gerryvel/NMEA2000_TPW/image.png

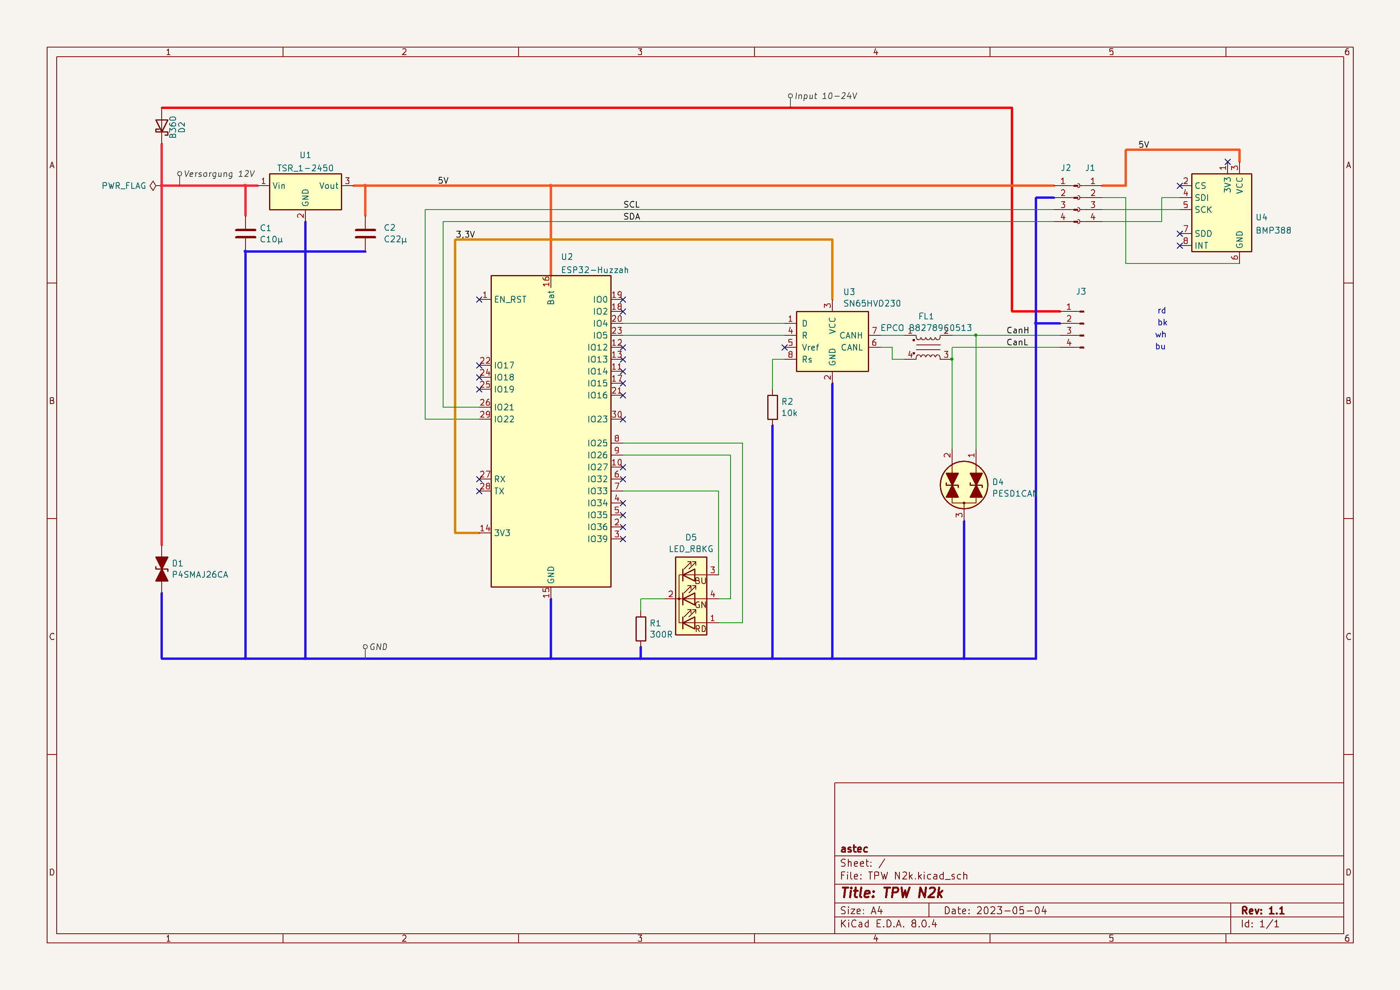
image.png
