gerryvel/NMEA2000_TPW/(threads)

Thread 6 (2022-11-13):

New Case and Board Layout

gerryvel, 2022-11-13:
- new case for "Hutschiene" 35mm
- new Board Layout
- change Stepdown switching regulators
- RGB LED

[Datenblatt_789-120_04.02.2022.pdf](https://github.com/gerryvel/NMEA2000_TPW/files/9998397/Datenblatt_789-120_04.02.2022.pdf)

[datenblatt-1050466-kingbright-l-154a4surkqbdzgw-led-mehrfarbig-rot-blau-gruen-rund-5-mm-200-mcd-300-mcd-1300-mcd-60-20-ma-195-v-33.pdf](https://github.com/gerryvel/NMEA2000_TPW/files/9998400/datenblatt-1050466-kingbright-l-154a4surkqbdzgw-led-mehrfarbig-rot-blau-gruen-rund-5-mm-200-mcd-300-mcd-1300-m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)

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

Closed 2023-03-25.
