gerryvel/NMEA2000_TPW/src/LED.h

#include "arduino.h"
#include "task.h"

//Configuration LED
//const int LEDBoard = 2;  //DevModule
const int LEDBoard = 13;   //Adafruit Huzzah32

enum LED {
  Red = 25, 
  Green = 26, 
  Blue = 33
  };

void LEDblink(int PIN = LED()){
 taskBegin();
   while(1)   // blockiert dank der TaskPause nicht 
   {
      digitalWrite(PIN,HIGH);  // LED ein
      taskPause(5);   // gibt Rechenzeit ab         
      digitalWrite(PIN,LOW);   // LED aus
      taskPause(1000);   // gibt Rechenzeit ab         
   }
   taskEnd();   
}

void LEDflash(int PIN = LED()){
   taskBegin();
   while(1)   // blockiert dank der TaskPause nicht 
   {
      digitalWrite(PIN,HIGH);  // LED ein
      taskPause(5);   // gibt Rechenzeit ab    
      digitalWrite(PIN,LOW);   // LED aus
      taskPause(250);   // gibt Rechenzeit ab    
   }
   taskEnd();   
}

// Flash LED for x ms
void flashLED(int PIN = LED(), int duration = 0){
 digitalWrite(PIN, HIGH); 
 delay(duration);
 digitalWrite(PIN, LOW);
}

void LEDInit() {                        // Start Initialisierung
  pinMode(LED(Red),   OUTPUT);
  pinMode(LED(Blue),  OUTPUT);
  pinMode(LED(Green), OUTPUT);
  digitalWrite(LED(Red), HIGH);
  delay(250);
  digitalWrite(LED(Red), LOW);
  digitalWrite(LED(Blue), HIGH);
  delay(250);
  digitalWrite(LED(Blue), LOW);
  digitalWrite(LED(Green), HIGH);
  delay(250);
  digitalWrite(LED(Green), LOW);
}

void LEDon(int PIN = LED()) {
  digitalWrite(PIN, HIGH);    
}

void LEDoff(int PIN = LED()) {
  digitalWrite(PIN, LOW);
}

void LEDoff_RGB() {
  digitalWrite(LED(Blue), LOW);
  digitalWrite(LED(Green),LOW);
  digitalWrite(LED(Red), LOW);
}
