gerryvel/NMEA2000_TPW/(commit log)

2024-06-26 Version 2.0
    [configuration.h]
2024-07-03 Version V2.0.1
    [configuration.h]
2024-07-05 Version 2.1
    [configuration.h]
2024-09-19 Update LED output
2024-09-23 V 2.3
    [configuration.h]
2024-10-28 V 2.4
    [configuration.h]
2025-02-04 V 2.5
    [configuration.h]
2026-05-07 V 2.5.1
    [configuration.h]
2026-07-01 V 2.5.2
    [configuration.h]
2026-10-30 Enhance README with sensor and setup information
    Updated README with sensor details and connection information.
2026-10-30 Replace wiring diagram image in README
    Updated wiring diagram image link in README.
